gl35/usAnemometer/PCB/PDM_Receiver/pcbA.JPG

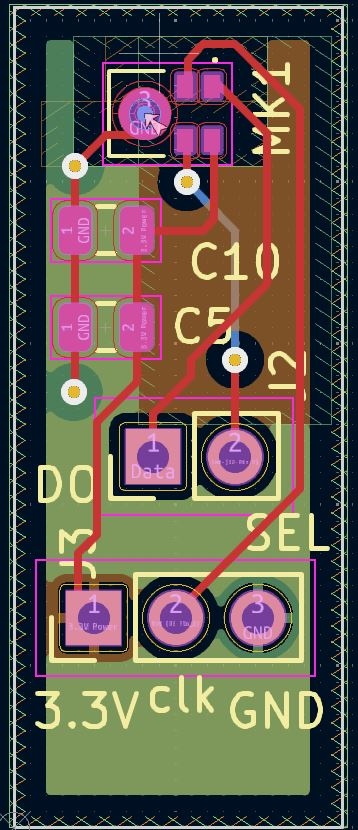
PCB/PDM_Receiver/pcbA.JPG
