gl35/usAnemometer/PCB/simulation/PDM_toDflipflop.JPG

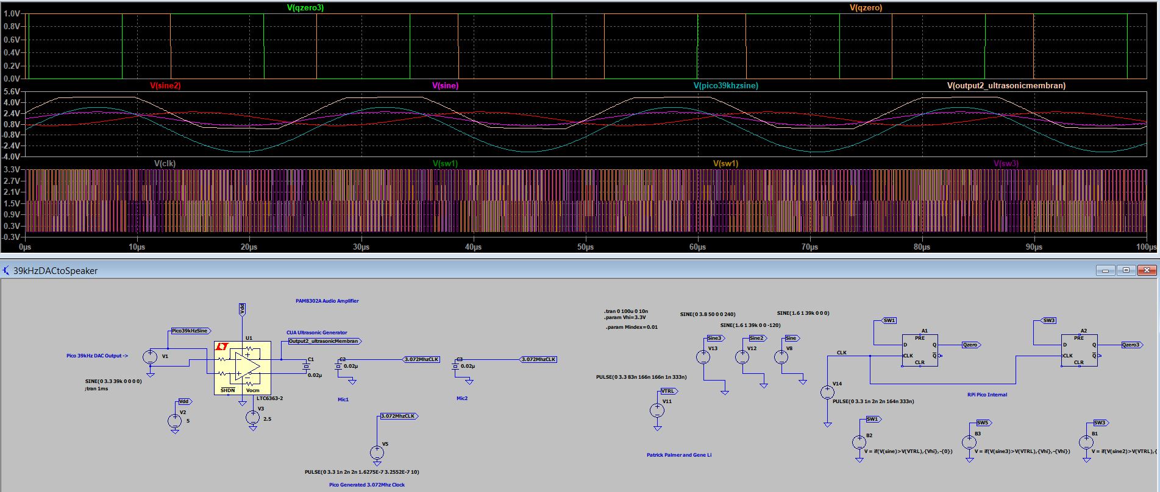
PCB/simulation/PDM_toDflipflop.JPG
