gl35/usAnemometer/program/Readme.txt

main is the one that uses machine.time_pulse_us pin pin27 to calculate the pulse width on the PLL output
