gl35/usAnemometer/PCB/datasheet/PAM8302_digital_Amp_sch.JPG

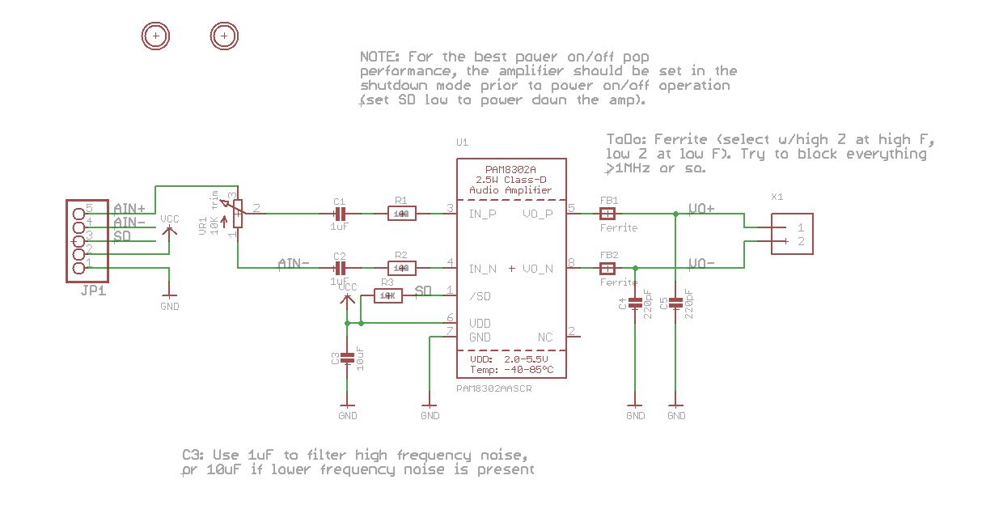
PCB/datasheet/PAM8302_digital_Amp_sch.JPG
