gl35/usAnemometer/PCB/simulation/mic_toPico.JPG

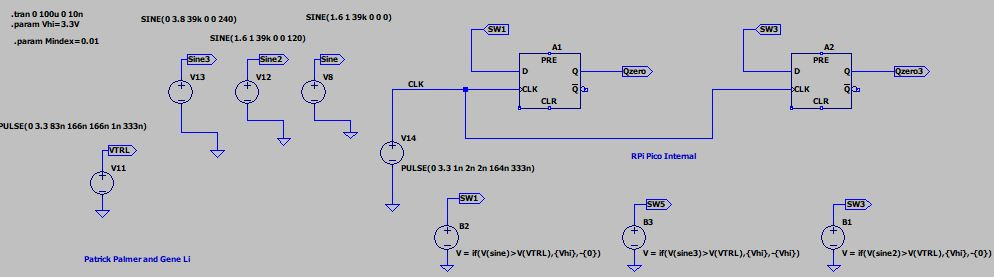
PCB/simulation/mic_toPico.JPG
