gl35/usAnemometer/PCB/simulation/pick_toSpeaker.JPG

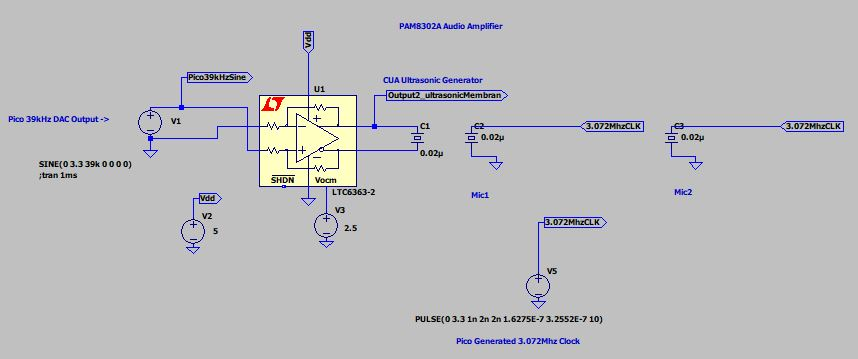
PCB/simulation/pick_toSpeaker.JPG
