gl35/usAnemometer/program/pdm/pcb/ver0.1/mico.step

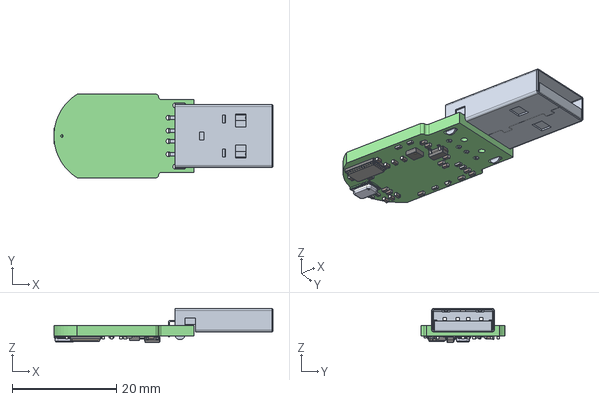
[picture p30: CAD file, 2024-07-19]
program/pdm/pcb/ver0.1/mico.step
41.9 x 16.0 x 6.55 mm
