gl35/usAnemometer/program/pdm/pcb/ver0.1/step/RP2040.step

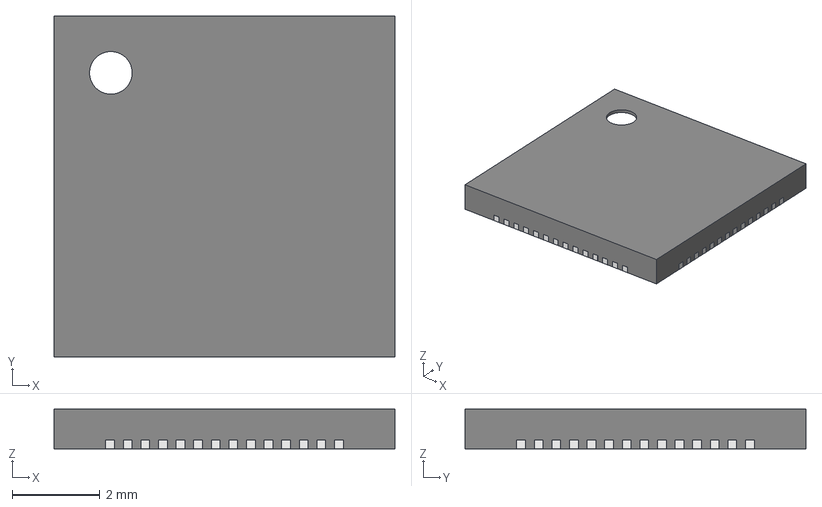
[picture p31: CAD file, 2024-07-19]
program/pdm/pcb/ver0.1/step/RP2040.step
7.75 x 7.75 x 0.901 mm
Open_CASCADE_STEP_translator_6.8_5.1
Open_CASCADE_STEP_translator_6.8_5.2.1
Thermal_Shape
Open_CASCADE_STEP_translator_6.8_5.4.1 x 56
