gl35/usAnemometer/program/pdm/pcb/ver0.1/step/XTAL1140X470X420N.step

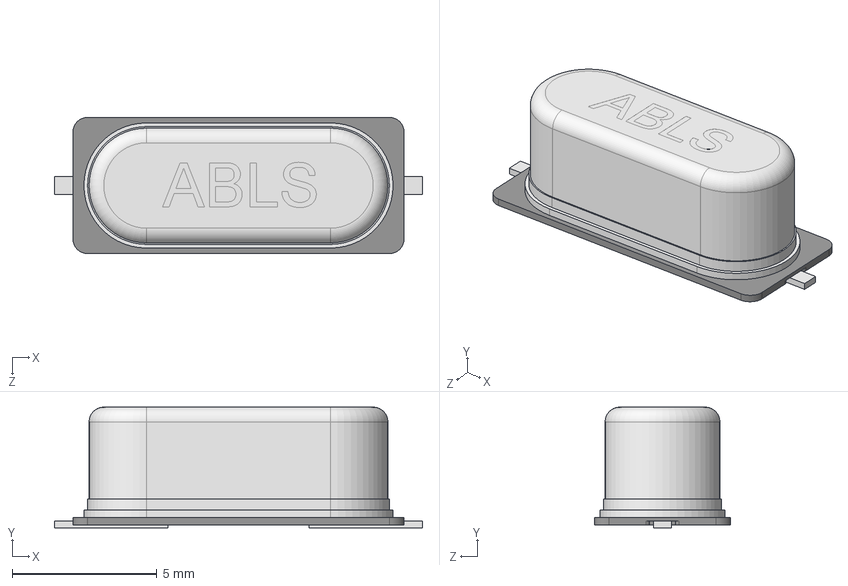
[picture p32: CAD file, 2024-07-19]
program/pdm/pcb/ver0.1/step/XTAL1140X470X420N.step
12.7 x 4.17 x 4.70 mm
