gl35/usAnemometer/PCB/mainBoard/mainBoard_schematic.pdf

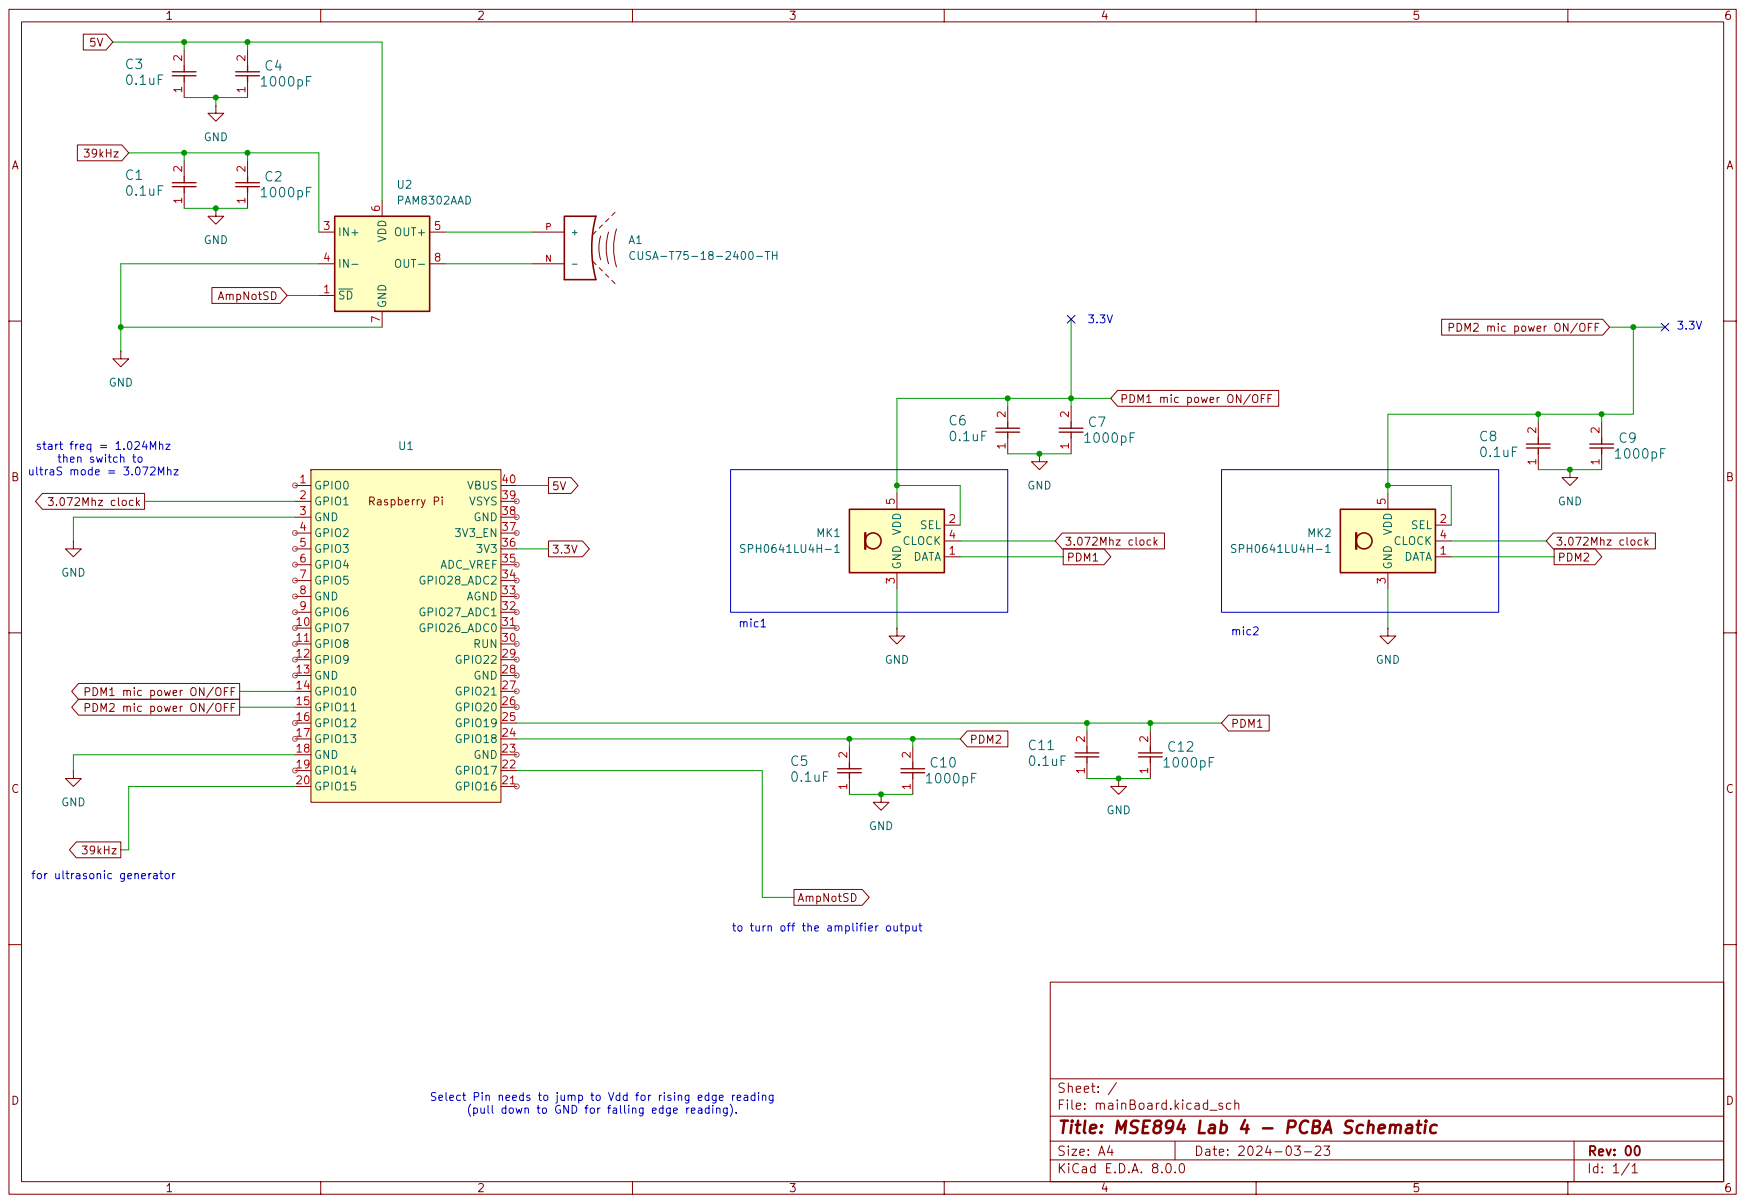
[picture p33: page 1]
