gl35/usAnemometer/PCB/simulation/39kHzDACtoSpeaker.asc

A1: dflop
A2: dflop
B1: bv; V = if(V(sine2)>V(VTRL),{Vhi},-{0})
B2: bv; V = if(V(sine)>V(VTRL),{Vhi},-{0})
B3: bv; V = if(V(sine3)>V(VTRL),{Vhi},-{Vhi})
C1: xtal; 0.02µ; V=100 Rser=204
C2: xtal; 0.02µ; V=100 Rser=204
C3: xtal; 0.02µ; V=100 Rser=204
U1: LTC6363-2
V1: voltage; SINE(0 3.3 39k 0 0 0 0)
V2: voltage; 5
V3: voltage; 2.5
V5: voltage; PULSE(0 3.3 1n 2n 2n 1.6275E-7 3.2552E-7 10)
V8: voltage; SINE(1.6 1 39k 0 0 0)
V11: voltage; PULSE(0 3.3 83n 166n 166n 1n 333n)
V12: voltage; SINE(1.6 1 39k 0 0 120)
V13: voltage; SINE(0 3.8 39k 0 0 240)
V14: voltage; PULSE(0 3.3 1n 2n 2n 164n 333n)
Named nets: 0, Vdd, 3.072MhzCLK, VTRL, SW1, SW3, Sine, Sine2, SW5, Sine3, CLK, Qzero, Qzero3, Pico39kHzSine, Output2_ultrasonicMembran
;tran 1ms
Pico 39kHz DAC Output ->
PAM8302A Audio Amplifier
CUA Ultrasonic Generator
Mic1
Mic2
Pico Generated 3.072Mhz Clock
.tran 0 100u 0 10n
.param Vhi=3.3V
.param Mindex=0.01
Patrick Palmer and Gene Li
RPi Pico Internal
