gl35/usAnemometer/PCB/simulation/PDM_V1.asc

A1: dflop
A2: dflop
B1: bv; V = if(V(sine3)>V(VTRL),{Vhi},-{Vhi})
B4: bv; V = if(V(sine2)>V(VTRL),{Vhi},-{0})
B5: bv; V = if(V(sine)>V(VTRL),{Vhi},-{0})
V2: voltage; SINE(1.6 1 39k 0 0 -120)
V4: voltage; SINE(1.6 1 39k 0 0 0)
V5: voltage; PULSE(0 3.3 83n 166n 166n 1n 333n)
V7: voltage; PULSE(0 3.3 1n 2n 2n 164n 333n)
V10: voltage; SINE(0 3.8 50 0 0 240)
Named nets: VTRL, SW1, SW3, Sine, 0, Sine2, SW5, Sine3, CLK, Qzero, Qzero3
.tran 0 100u 0 10n
.param Vhi=3.3V
Isolated Gate drivers connected Gate to Source!
.param Mindex=0.01
Patrick Palmer and Gene Li
