gl35/usAnemometer/PCB/simulation/TransmissionPulse_Fully_Matched.asc

A1: dflop
A2: inv
C1: cap; 0.02µ
R2: res; 204
V1: voltage; PULSE(0 1 5n 2n 2n 1.6275E-7 3.2552E-7 10)
V2: voltage; PULSE(0 1 0 0.81E-7 0.81E-7 0.16275E-7 3.2552E-7 10)
V3: voltage; SINE(0 3.3 39000 0 0 0)
V4: voltage
V5: voltage; PULSE(0 1 1n 2n 2n 1.6275E-7 3.2552E-7 10)
Named nets: 0, IN, J, clk, zeroX_sig1, switch1
.tran 0 100ms 0 .5u
39khz sinewave with lowpass filter
39khz Sinewave Input to mic
switch1 = If (V2 > V3, 1, 0)
