gl35/usAnemometer/(list of files, drawings)

Other design files:
PCB/simulation/THS4522.DSN
PCB/simulation/THS4522.OLB
PCB/simulation/THS4522.OPJ
