gl35/usAnemometer/PCB/PDM_Receiver/PDM_Receiver.kicad_pcb

## KiCad design PCB/PDM_Receiver/PDM_Receiver.kicad_pcb (2025-08-11)

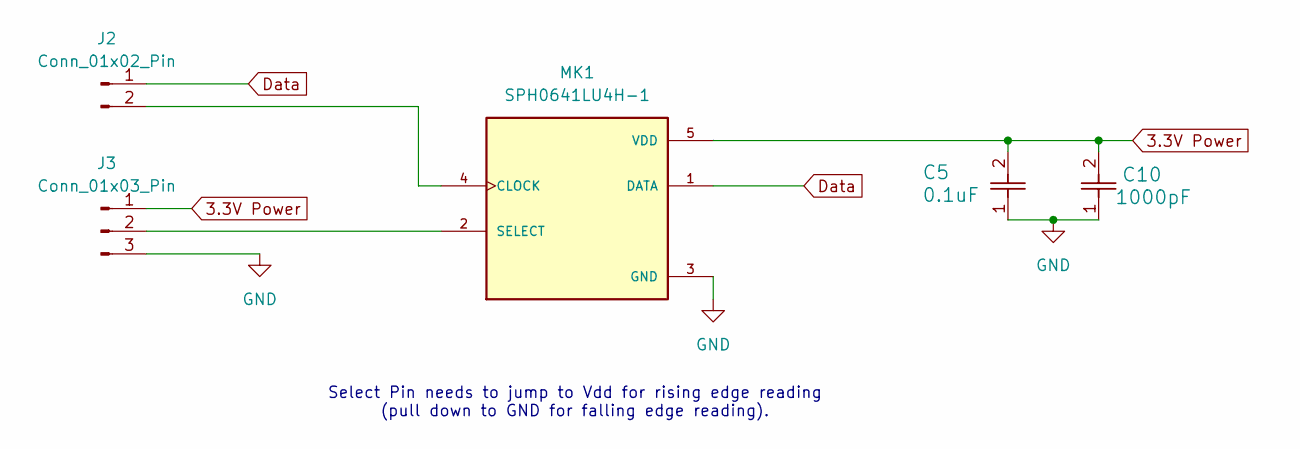
[picture p35: schematic PDM_Receiver.kicad_sch, MSE894 Lab 4 - PCBA Schematic]

Parts:
C5: 0.1uF; C_0805_2012Metric
C10: 1000pF; C_0805_2012Metric
J2: Conn_01x02_Pin; PinHeader_1x02_P2.54mm_Vertical
J3: Conn_01x03_Pin; PinHeader_1x03_P2.54mm_Vertical
MK1: SPH0641LU4H-1; MIC_SPH0641LU4H-1; DIGI-KEY_PART_NUMBER 423-1402-1-ND

Connections:
3.3V Power: C5.2, C10.2, J3.1, MK1.5 (VDD)
Data: J2.1, MK1.1 (DATA)
GND: C5.1, C10.1, J3.3, MK1.3 (GND)
unnamed: J2.2, MK1.4 (CLOCK)
unnamed: J3.2, MK1.2 (SELECT)

Notes on the sheet:
Select Pin needs to jump to Vdd for rising edge reading (pull down to GND for falling edge reading).

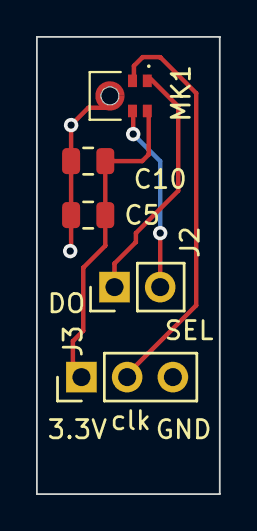
[picture p36: board PDM_Receiver.kicad_pcb from above]

Board: 4 copper layers, 10.2 x 25.4 mm, 5 parts (0 on the bottom side), 5 nets.
