gl35/usAnemometer/PCB/mainBoard/mainBoard/mainBoard.kicad_pcb

## KiCad design PCB/mainBoard/mainBoard/mainBoard.kicad_pcb (2025-08-11)

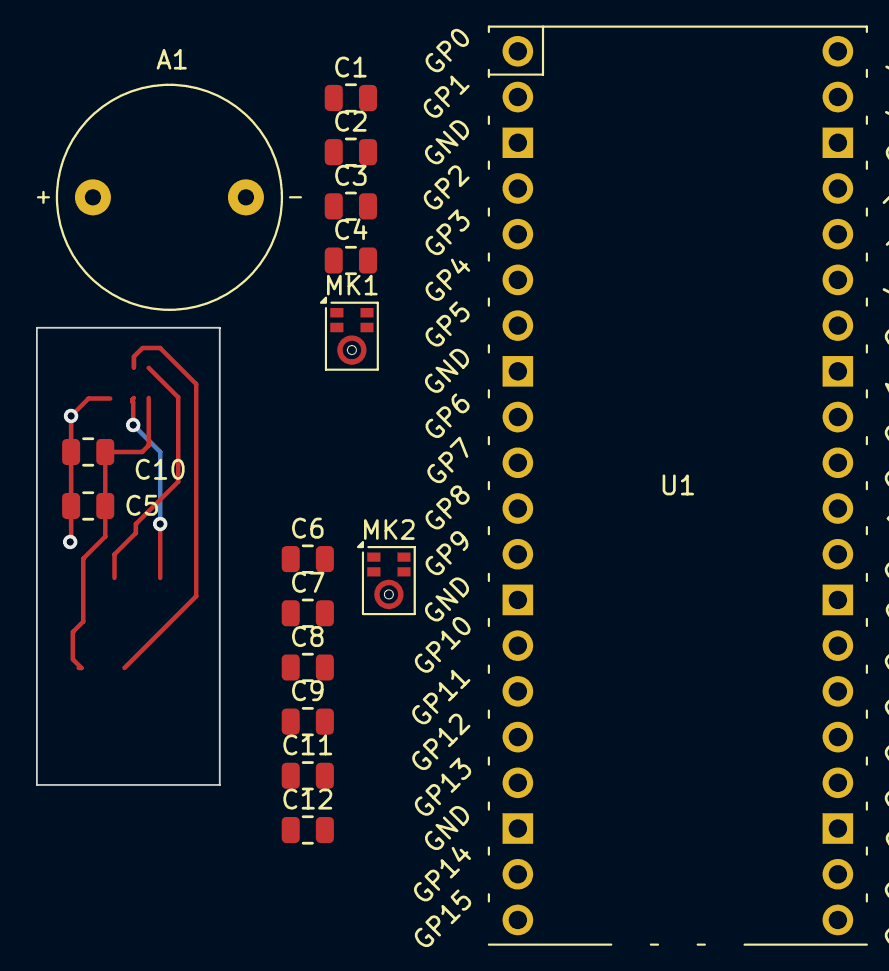
[picture p37: board mainBoard.kicad_pcb from above]

Board: 4 copper layers, 16 parts (0 on the bottom side), 7 nets.

Parts:
A1: CUSA-T75-18-2400-TH; XDCR_CUSA-T75-18-2400-TH
C1, C3, C5, C6, C8, C11: 0.1uF; C_0805_2012Metric
C2, C4, C7, C9, C10, C12: 1000pF; C_0805_2012Metric
MK1, MK2: SPH0641LU4H-1; Knowles_LGA-5_3.5x2.65mm
U1: Pico W

Connections:
3.3V: C6.2, C7.2, C8.2, C9.2, MK1.2 (SEL), MK1.5 (VDD), MK2.2 (SEL), MK2.5 (VDD), U1.36 (3V3)
3.072Mhz clock: MK1.4 (CLOCK), MK2.4 (CLOCK), U1.21 (GPIO16)
39kHz: C1.2, C2.2, U1.1 (GPIO0)
GND: C1.1, C2.1, C3.1, C4.1, C5.1, C6.1, C7.1, C8.1, C9.1, C10.1, C11.1, C12.1, MK1.3 (GND), MK2.3 (GND), U1.3 (GND)
PDM1: C11.2, C12.2, MK1.1 (DATA), U1.25 (GPIO19)
PDM2: C5.2, C10.2, MK2.1 (DATA), U1.24 (GPIO18)
Vbus: C3.2, C4.2
