gl35/usAnemometer/program/pdm/pcb/ver0.1/mico.kicad_pcb

## KiCad design program/pdm/pcb/ver0.1/mico.kicad_pcb (2024-07-19)

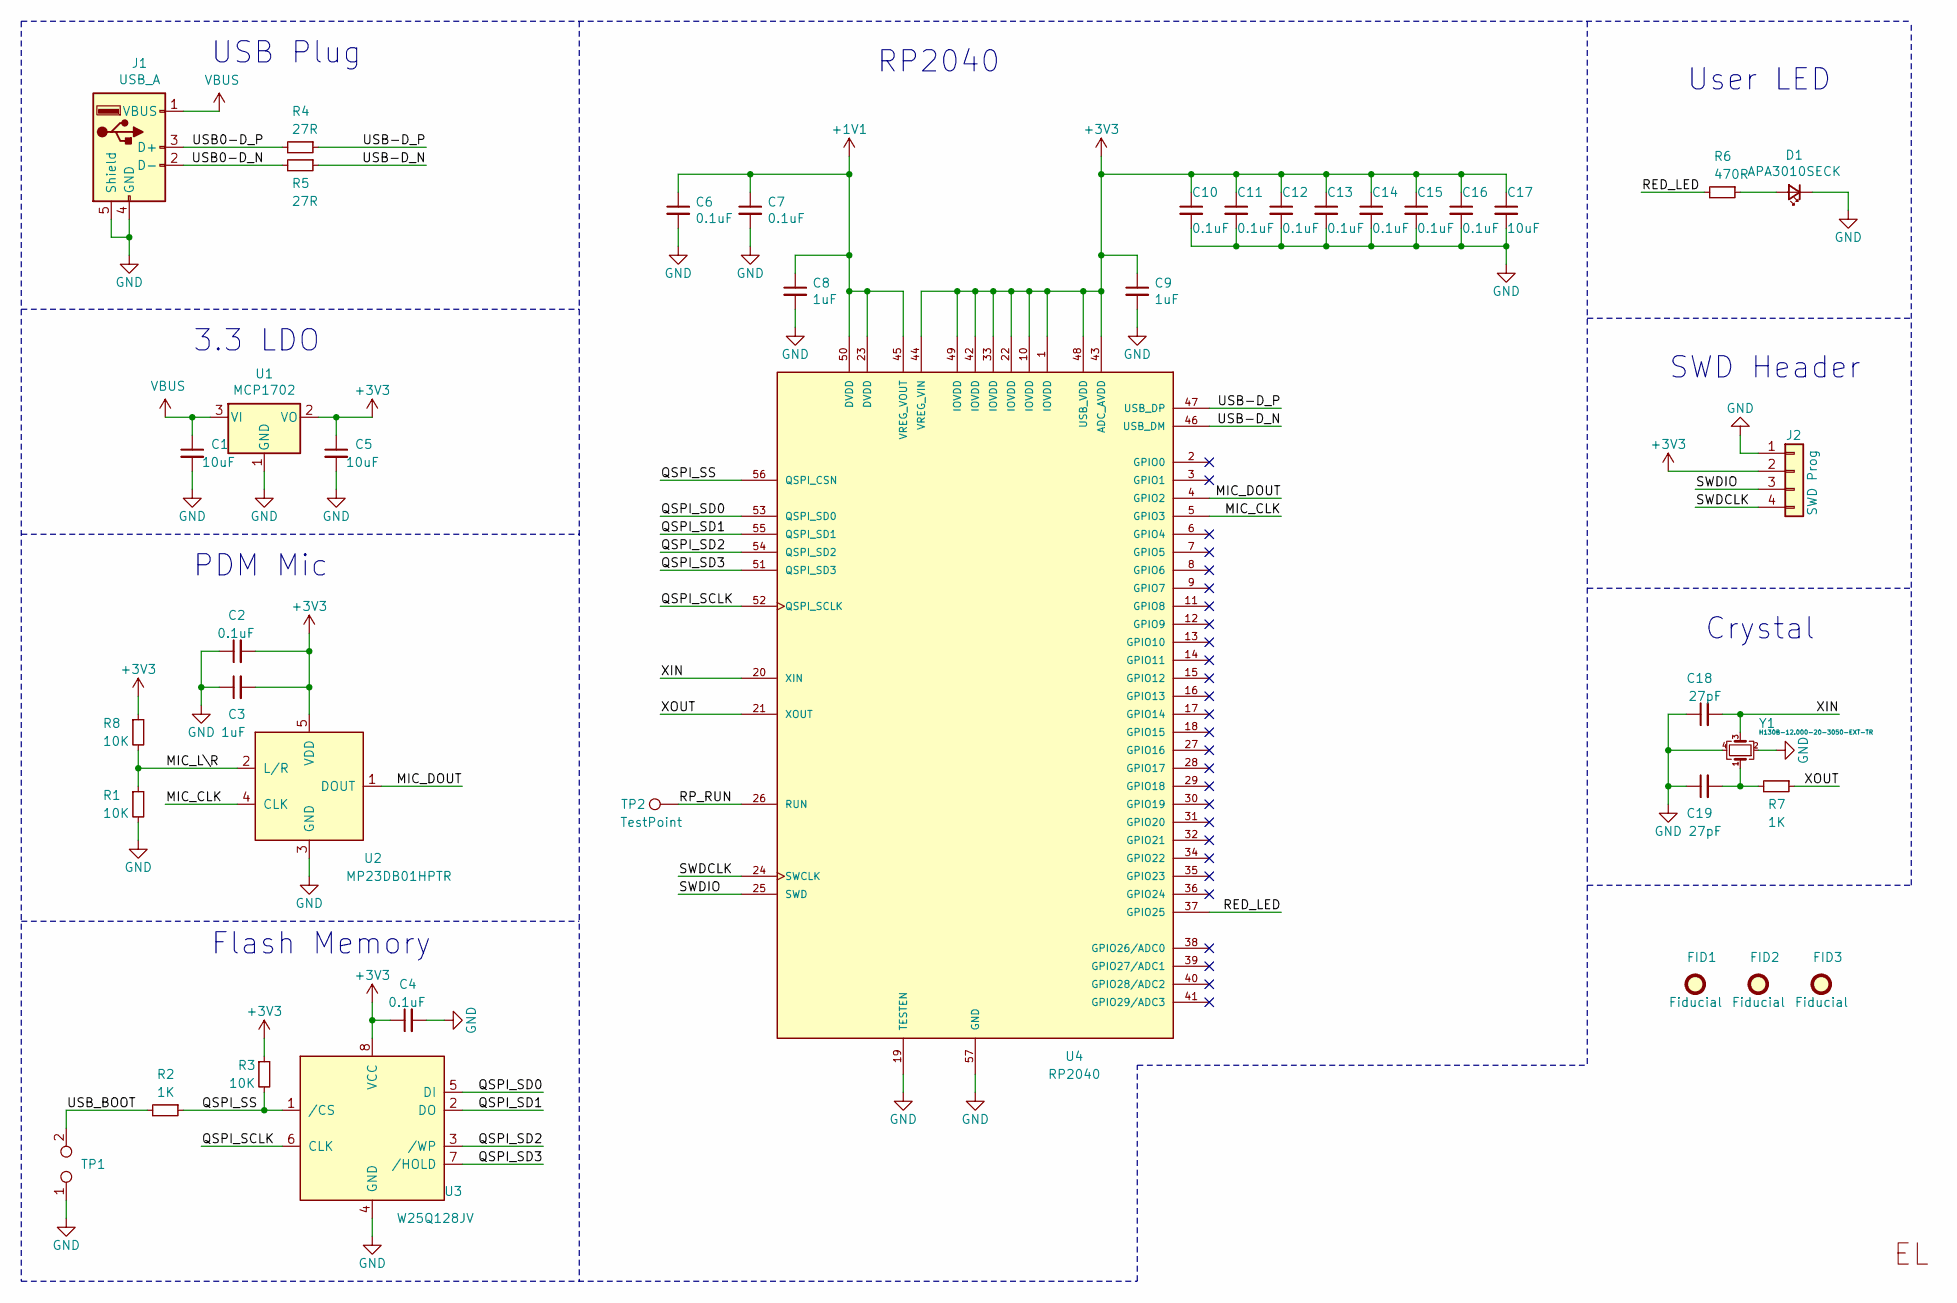
[picture p38: schematic mico.sch]

Parts:
C1, C5, C17: 10uF; C_0402_1005Metric
C2, C4, C6, C7, C10, C11, C12, C13, C14, C15, C16: 0.1uF; C_0402_1005Metric
C3, C8, C9: 1uF; C_0402_1005Metric
C18, C19: 27pF; C_0402_1005Metric
D1: APA3010SECK; LED_0402_1005Metric
FID1, FID2, FID3: Fiducial; Fiducial_0.5mm_Mask1mm
J1: USB_A; USB-A
J2: SWD Prog; SMD_1x04_P1.27mm
R1, R3, R8: 10K; R_0402_1005Metric
R2, R7: 1K; R_0402_1005Metric
R4, R5: 27R; R_0402_1005Metric
R6: 470R; R_0402_1005Metric
TP1: TestPoint_2Pole; SMD_1x02_P1.27mm
TP2: TestPoint; SMD_1x01_P1.27mm
U1: MCP1702; SOT-23
U2: MP23DB01HPTR; MIC_SPH0641LU4H-1
U3: W25Q128JV; PSON50P300X200X60-9N
U4: RP2040; QFN40P700X700X90-57N; PARTREV 1.6.1
U5: logo; el_logo-9P4_3P1
Y1: H130B-12.000-20-3050-EXT-TR; Crystal_SMD_5032-4Pin_5.0x3.2mm

Connections:
+1V1: C6.1, C7.1, C8.1, U4.23 (DVDD), U4.45 (VREG_VOUT), U4.50 (DVDD)
+3V3: C2.2, C3.2, C4.1, C5.1, C9.1, C10.1, C11.1, C12.1, C13.1, C14.1, C15.1, C16.1, C17.1, J2.2, R3.1, R8.1, U1.2 (VO), U2.5 (VDD), U3.8 (VCC), U4.1 (IOVDD), U4.10 (IOVDD), U4.22 (IOVDD), U4.33 (IOVDD), U4.42 (IOVDD), U4.43 (ADC_AVDD), U4.44 (VREG_VIN), U4.48 (USB_VDD), U4.49 (IOVDD)
/MIC_CLK: U2.4 (CLK), U4.5 (GPIO3)
/MIC_DOUT: U2.1 (DOUT), U4.4 (GPIO2)
/MIC_L\R: R1.1, R8.2, U2.2 (L/R)
/QSPI_SCLK: U3.6 (CLK), U4.52 (QSPI_SCLK)
/QSPI_SD0: U3.5 (DI), U4.53 (QSPI_SD0)
/QSPI_SD1: U3.2 (DO), U4.55 (QSPI_SD1)
/QSPI_SD2: U3.3 (/WP), U4.54 (QSPI_SD2)
/QSPI_SD3: U3.7 (/HOLD), U4.51 (QSPI_SD3)
/QSPI_SS: R2.1, R3.2, U3.1 (/CS), U4.56 (QSPI_CSN)
/RED_LED: R6.2, U4.37 (GPIO25)
/RP_RUN: TP2.1, U4.26 (RUN)
/SWDCLK: J2.4, U4.24 (SWCLK)
/SWDIO: J2.3, U4.25 (SWD)
/USB0-D_N: J1.2 (D-), R5.2
/USB0-D_P: J1.3 (D+), R4.2
/USB-D_N: R5.1, U4.46 (USB_DM)
/USB-D_P: R4.1, U4.47 (USB_DP)
/USB_BOOT: R2.2, TP1.2
/XIN: C18.2, U4.20 (XIN), Y1.3
/XOUT: R7.1, U4.21 (XOUT)
GND: C1.2, C2.1, C3.1, C4.2, C5.2, C6.2, C7.2, C8.2, C9.2, C10.2, C11.2, C12.2, C13.2, C14.2, C15.2, C16.2, C17.2, C18.1, C19.1, D1.1 (K), J1.4 (GND), J1.5 (Shield), J2.1, R1.2, TP1.1, U1.1 (GND), U2.3 (GND), U3.4 (GND), U4.19 (TESTEN), U4.57 (GND), Y1.2, Y1.4
unnamed: C19.2, R7.2, Y1.1
unnamed: D1.2 (A), R6.1
VBUS: C1.1, J1.1 (VBUS), U1.3 (VI)

Notes on the sheet:
USB Plug
3.3 LDO
PDM Mic
Flash Memory
User LED
SWD Header
Crystal
RP2040

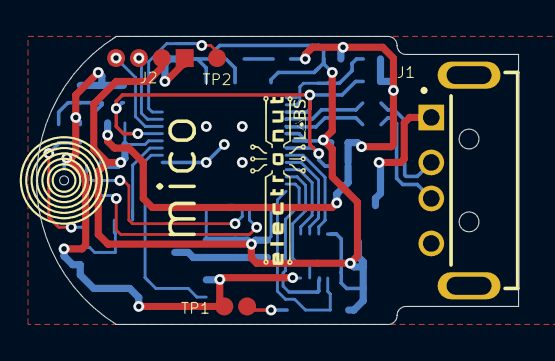
[picture p39: board mico.kicad_pcb from above]

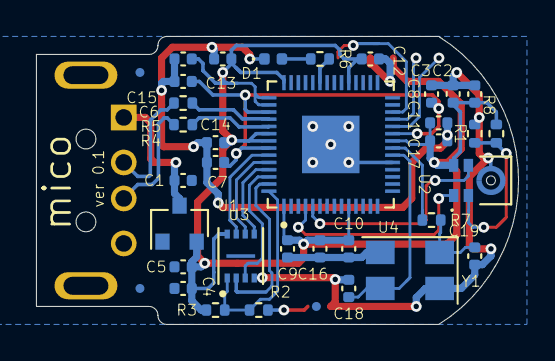
[picture p40: board mico.kicad_pcb from below]

Board: 2 copper layers, 26.8 x 16.0 mm, 41 parts (36 on the bottom side), 26 nets.
