gl35/usAnemometer/program/main_r5_2sine_DFF.py

'''Blink the on board LED Pico W pinouts only
Patrick Palmer Jan 2024'''
from machine import Pin, Timer, PWM, UART, ADC, RTC
from neotimer import *
from rp2 import PIO, StateMachine, asm_pio
import utime 
#from array import *
import time, gc, _thread
import select
import sys
import array


rtc = RTC()

timer = machine.Timer() # timer for the blinking led

led = machine.Pin("LED", machine.Pin.OUT) #GPIO LED
shutdownDamp = Pin (17, Pin.OUT) #SHUTDown Digital Amplifier GPIO 17

pdm1_On = Pin (10, Pin.OUT) #GPIO 10 & 11 to power on and off the PDM mics
pdm2_On = Pin (11, Pin.OUT)


#LED blinking logic
# led.on()
def blink(timer):
    led.off() 
# timer.init(freq=10, mode=Timer.PERIODIC, callback=blink)

#1st PWM - 39kHz to excit the ultrasonic generator
pwm1 = PWM ( Pin ( 15, Pin.OUT ) ) # GP15
pwm1.freq ( 1000 ) # 39kHz
pwm1.duty_u16 ( 32767 ) # duty 50% (65535/2)

#2nd PWM - 1.024Mhz clk for PDM mic
fclk = 1024000 #variable for PDM clock frequency
pwm2 = PWM ( Pin ( 1, Pin.OUT ) ) # GP1
pwm2.freq ( fclk ) # fclk = 1.024MHz, 3.072Mhz 
pwm2.duty_u16 (32767 ) # duty 50% (65535/2)

pwm3 = PWM ( Pin (22, Pin.OUT) ) # GP22 for dflipflop 48000hz
pwm3.freq (16000000)
pwm3.duty_u16 (32767)

#ADC value for PDM mic 2
# pdm1 = ADC(Pin(26))     # create ADC object on ADC pin GPIO26 - variable name is pdm1 and not adc1 - uncomment if using pdm mic

adc1 = ADC(Pin(26))     # create ADC object on ADC pin GPIO26 mic1 - uncomment if using analog mic
adc2 = ADC(Pin(27))     # create ADC object on ADC pin GPIO27 mic2 - uncomment if using analog mic 
adc3 = ADC(Pin(28)) # create ADC on gpio28 for the dff output.

analogV_arr1 = [] #needs more work on array
time_arr1 = []
volt1 = []

analogV_arr2 = [] #needs more work on array
time_arr2 = []
volt2 = []

dff2 = Pin( 18, Pin.IN) # GPIO18 Dflipflop output for PDM2
dff1 = Pin( 19, Pin.IN) # GPIO11 Dflipflop output for PDM1

global ch

machine.freq(125000000)
# class ticker:
#     def count(self):
#         st = time.ticks_ns()
#         tic = 0
#         while tic < 1000000:
#             x += 1
#             print(x)
#             et = time.ticks_ns()
#             return et-st, x
        
#analog mic adc value function
i =0;
def adc_val():
    for i in range(0, 400):
        time_arr1.append( utime.time_ns())
        analogV_arr1.append( adc1.read_u16())
        #volt1.append(analogV_arr1)
        
        time_arr2.append( utime.time_ns())
        analogV_arr2.append( adc2.read_u16())
        #volt2.append(analogV_arr2)
        #uncomment to valid the data in excel
#         print("Time1 =", time_arr1)
#         print("Analog Value1 =", analogV_arr1)
#         print("Time2 =", time_arr2)
#         print("Analog Value2 =", analogV_arr2)
#         utime.sleep_us(1)

#PDM to ADC function

def PDM_adc():
    for i in range(0, 250):
        analogV_arr[i] = (pdm1.read_u16()/4096)
        #print("Analog Value =", analogV_arr)
        utime.sleep_us(20)

conversion_fact = float()
conversion_fact = 3.3/(65535)

analog = float()
#convert raw data to voltage and if V > 1.5v then store time
def ADCscaling():
    v = adc3.read_u16() * conversion_fact
#     volt1.append (v.value)
    return v
 
    
#calculate time
deltaT = 0
time1 = float()
time2 = float()
time_arr = []  # time array for storing the time when voltage is < 2.54
time_old = 1
time_new = 2
windspeed = float()

def calTime():
    global deltaT 
    global time1
    global time2
    global windspeed
    global time_arr
    global time_new
    global time_old
    
    ADCscaling()
#     for i in range(0, 6):
    if ADCscaling() <= 2.45:
#             time_arr.append(utime.time_ns())
        time_new = utime.ticks_us()
        if time_new != utime.ticks_us():
            time_old = time_new          
            deltaT = utime.ticks_diff(utime.ticks_us(), time_new) # need more work on fixing the array out of index
    print("TOF = ", deltaT)
    windspeed = 0.2/((deltaT*10**-6)*22.75)
    print("windspeed = ", windspeed)
    
    return deltaT


_thread.start_new_thread(calTime, ())

#@asm_pio(set_init=PIO.OUT_HIGH)
# def usPulse():
#     print ("Start Digital Amplifier")
#     set(pins, 1)   
#     adc_val() 
#     pwm1.freq ( 39000 ) # 39kHz
#     pwm1.duty_u16 ( 32767 )             
#     utime.sleep_ms(35)
#     set(pins, 0)  
#     
#@asm_pio(set_init=PIO.OUT_LOW)
# def usPulseL():
#     set(pins, 0)  
#     print ("Shut Down Digital Amplifier")
#     fclk = 1024000
#     pwm2.freq ( fclk )
#     pdm2_On(0)
#     #reset the array values
#     time_arr1 = 0
#     analogV_arr1 = 0
#     time_arr2 = 0
#     analogV_arr2 = 0
#     
# sm1 = StateMachine( 1, usPulse, freq = 125000000, set_base=Pin(17) )
# sm2 = StateMachine( 2, usPulseL, freq = 125000000, set_base=Pin(17) )
# def StateM_func():
#     while True:
#         sm1.active(1)
#         utime.sleep_ms(50)
#         sm1.active(0)
#         
#         sm2.active(1)
#         utime.sleep_ms(50)
#         sm2.active(0)
#         
# _thread.start_new_thread(StateM_func, ())

cntr = 0
    
'''UART communication'''
#class uartComm:
    #def call(self):
def uartComm():
    poll_obj = select.poll()
    poll_obj.register(sys.stdin, 1)
    
    global deltaT 
    while True:
        calTime()
#         windspeed = 0.2/((deltaT*10**-6)*22.75)
#         time.sleep(1)

    #dff2
    #dff1
    #print(dff2.value())
    #print(PDM2)
#         print(dff1.value())
        
#         if dff2.value() == True:
#             time1 = rtc.datetime()
#         if dff1.value() == True:
#             time2 = rtc.datetime()
#             deltaT = time2 - time1
        if poll_obj.poll(0):
            ch = sys.stdin.read(1)
            if ch == 's': #press t to shutdown
                print ("Start Digital Amplifier")
                #fclk = 39000;                
                shutdownDamp.value(1)   
                
                pwm1.freq ( 39000 ) # 39kHz
                pwm1.duty_u16 ( 32767 )
#                 _thread.start_new_thread(adc_val, ())  
#                 utime.sleep_ms(35)
#                 shutdownDamp.value(0)
                 
                #t = ticker.count
                pdm2_On(1)
                #ticker()

#                 PDM_adc()
#                 dff()
                ADCscaling()
                print("adc3 value =", ADCscaling())
                print("windspeed = ", windspeed)
                
                
            if ch == 't': # press s to start
                shutdownDamp.value (0)
                #PWM.deinit();
                print ("Shut Down Digital Amplifier")
                fclk = 1024000
                pwm2.freq ( fclk )
                pdm2_On(0)
                
                
            #for testing
            if ch == 'p':
                fclk = 3072000
                pwm2.freq ( fclk )
            if ch == 'm':
                fclk = fclk - 100
                pwm2.freq ( fclk )
                time.sleep(1)
                
#run the ticker in core 1
#_thread.start_new_thread(StateM_func, ())
#uart = uartComm()

# def main_loop():
#     uartComm()


while True:
    uartComm()
#     calTime()

    

'''
poll_obj = select.poll()
poll_obj.register(sys.stdin, 1)

def uartComm(ch):
    global poll_obj
    while True:
        if poll_obj.poll(0):
            ch = sys.stdin.read(1)
        if ch == 's': #press t to shutdown
            print ("Going to State0")
            state0.attach_transition(1, state1)
        if ch == 't': # press s to start
            state1.attach_transition(1, state0)
            print ("Going to State1")

        time.sleep(0.1)
        return ch
        
#Start working on state machine here
state_machine = StateMachine()
myTimer = Neotimer(1000)
#led = Pin(25,Pin.OUT)

#============================================================
# States Logic Functions
#============================================================
def state0_logic():
    # Referenced global variables
    # ----> Here <----
    global poll_obj
    #shutdownDamp = Pin (17, Pin.OUT) #SHUTDown Digital Amplifier GPIO 16
    
    if state_machine.execute_once:
        # ----> Code that executes just once during state <----
        # ----> Here <----
        print("Machine in State 0")
        
        myTimer.start()

    # Code that executes continously during state
    # ----> Here <----
    shutdownDamp.value (0);
    #PWM.deinit();
    print ("Shut Down Digital Amplifier")
    
    led.off()
    

def state1_logic():
    # Referenced global variables
    # ----> Here <----
    global poll_obj
    #shutdownDamp = Pin (17, Pin.OUT) #SHUTDown Digital Amplifier GPIO 16
    
    if state_machine.execute_once:
        # ----> Code that executes just once during state <----
        # ----> Here <----
        print("Machine in State 1")
        
        myTimer.start()
        
    # Code that executes continously during state
    # ----> Here <----
    shutdownDamp.value (1);
          
    print ("Start Digital Amplifier")
    #fclk = 39000;
    pwm1.freq ( fclk ) # 39kHz
    led.on()

#============================================================
# Add states to machine (Also create state objects)
#============================================================
# Create States
# ----> Here <----
state0 = state_machine.add_state(state0_logic)
state1 = state_machine.add_state(state1_logic)

#============================================================
# State Transitions Functions (optional)
#============================================================
# Create Transition Functions
# ----> Here <----
def delay_transition():
    if myTimer.finished():
        return True
    else:
        return False

#============================================================
# Attach transitions to states (optional)
#============================================================
#state0.attach_transition(delay_transition, state1)
#state1.attach_transition(delay_transition, state0)



def main_loop():
    #global variable
    global free_memory_threshold
    global ch
    # Manually invoke garbage collection
    # It might be required in both cores, but
    # start using it on the fastest looping core.

    if gc.mem_free() < free_memory_threshold:
        #lock.acquire()
        gc.collect()
        #lock.release()
        
    pass # Do something here
    
#------------------------------------------------------
# Run state machine code in second core
def state_machine_logic():
    while True:
        state_machine.run()

# Start state_machine_logic() on Core 1
_thread.start_new_thread(state_machine_logic, ())
#------------------------------------------------------


# Determine how much memory is free before starting
# main loop in Core 0. This will be used as threshold
# to determine if we should invoke gc.collect()
gc.collect()
free_memory_threshold = gc.mem_free()
print("Free memory",free_memory_threshold)

# Main Loop:
while True:
    main_loop()
'''    
